s0b0s/first-person-gate-array/pcb/carrier.kicad_pcb

## KiCad design pcb/carrier.kicad_pcb (2026-10-25)

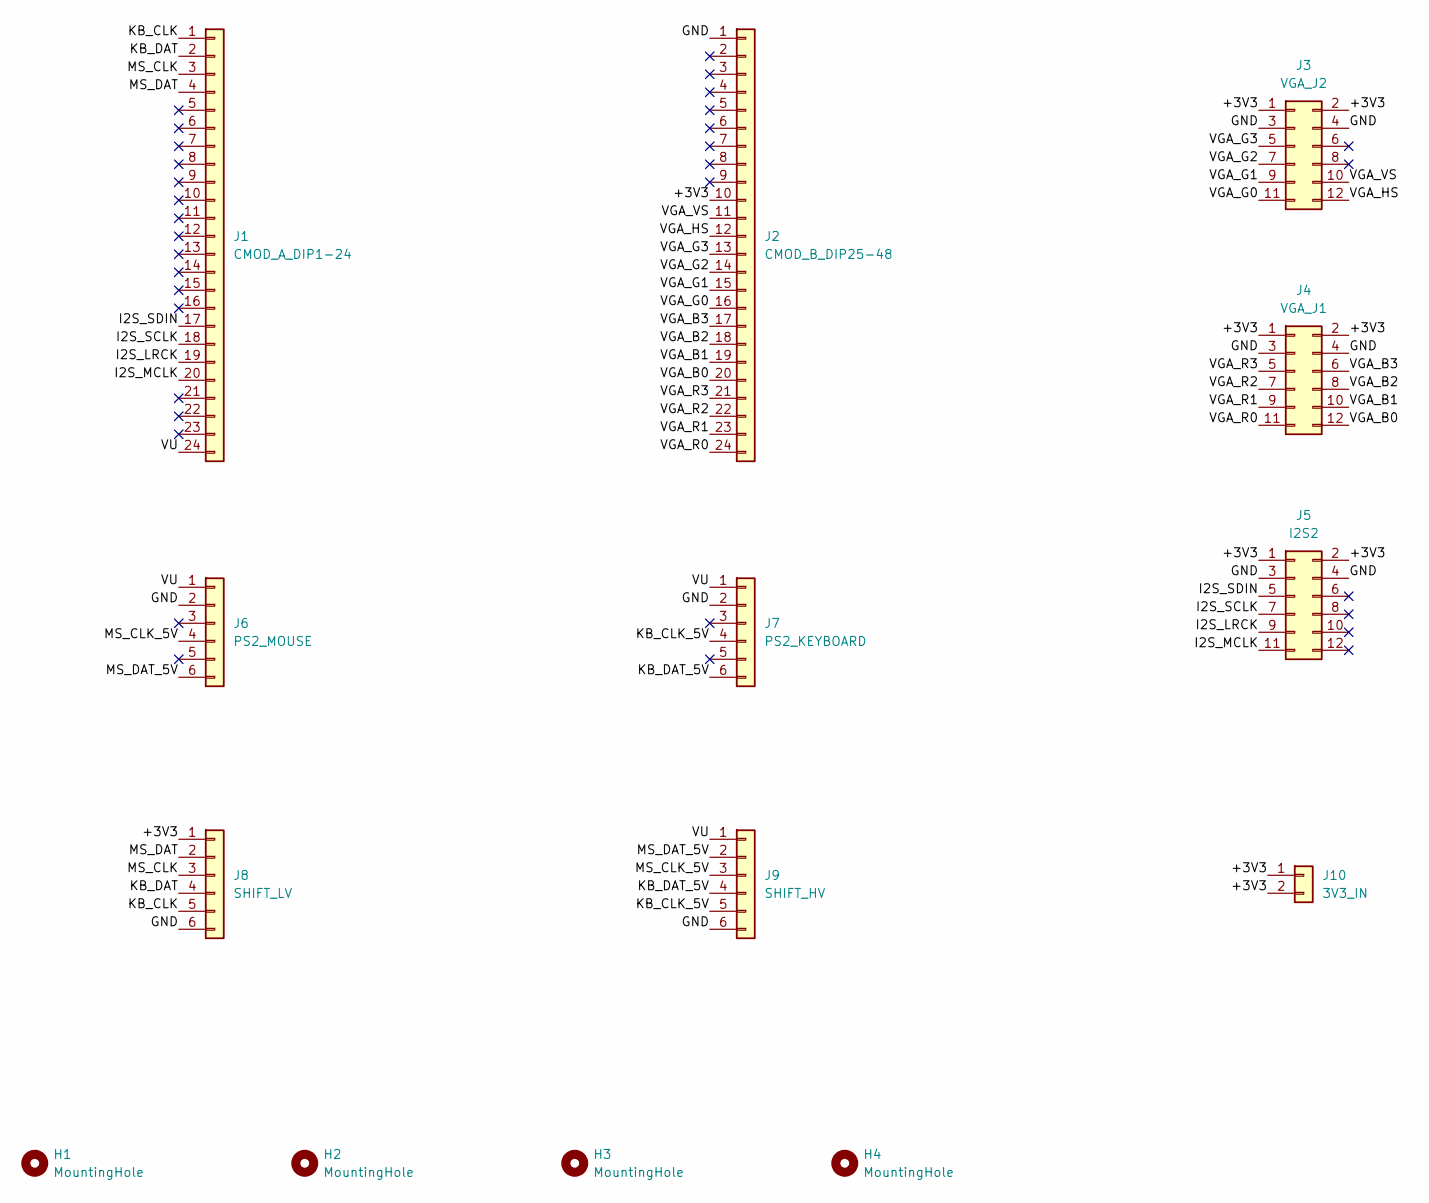
[picture p1: schematic carrier.kicad_sch, FPGA Shooter Game Carrier]

Parts:
H1, H2, H3, H4: MountingHole; MountingHole_3.2mm_M3
J1: CMOD_A_DIP1-24; PinSocket_1x24_P2.54mm_Vertical
J2: CMOD_B_DIP25-48; PinSocket_1x24_P2.54mm_Vertical
J3: VGA_J2; PinSocket_2x06_P2.54mm_Horizontal_Edge2mm
J4: VGA_J1; PinSocket_2x06_P2.54mm_Horizontal_Edge2mm
J5: I2S2; PinSocket_2x06_P2.54mm_Horizontal_Edge2mm
J6: PS2_MOUSE; PinSocket_1x06_P2.54mm_Horizontal_Edge2mm
J7: PS2_KEYBOARD; PinSocket_1x06_P2.54mm_Horizontal_Edge2mm
J8: SHIFT_LV; PinSocket_1x06_P2.54mm_Vertical
J9: SHIFT_HV; PinSocket_1x06_P2.54mm_Vertical
J10: 3V3_IN; PinSocket_1x02_P2.54mm_Vertical

Connections:
/+3V3: J2.10, J3.1, J3.2, J4.1, J4.2, J5.1, J5.2, J8.1, J10.1, J10.2
/GND: J2.1, J3.3, J3.4, J4.3, J4.4, J5.3, J5.4, J6.2, J7.2, J8.6, J9.6
/I2S_LRCK: J1.19, J5.9
/I2S_MCLK: J1.20, J5.11
/I2S_SCLK: J1.18, J5.7
/I2S_SDIN: J1.17, J5.5
/KB_CLK: J1.1, J8.5
/KB_CLK_5V: J7.4, J9.5
/KB_DAT: J1.2, J8.4
/KB_DAT_5V: J7.6, J9.4
/MS_CLK: J1.3, J8.3
/MS_CLK_5V: J6.4, J9.3
/MS_DAT: J1.4, J8.2
/MS_DAT_5V: J6.6, J9.2
/VGA_B0: J2.20, J4.12
/VGA_B1: J2.19, J4.10
/VGA_B2: J2.18, J4.8
/VGA_B3: J2.17, J4.6
/VGA_G0: J2.16, J3.11
/VGA_G1: J2.15, J3.9
/VGA_G2: J2.14, J3.7
/VGA_G3: J2.13, J3.5
/VGA_HS: J2.12, J3.12
/VGA_R0: J2.24, J4.11
/VGA_R1: J2.23, J4.9
/VGA_R2: J2.22, J4.7
/VGA_R3: J2.21, J4.5
/VGA_VS: J2.11, J3.10
/VU: J1.24, J6.1, J7.1, J9.1

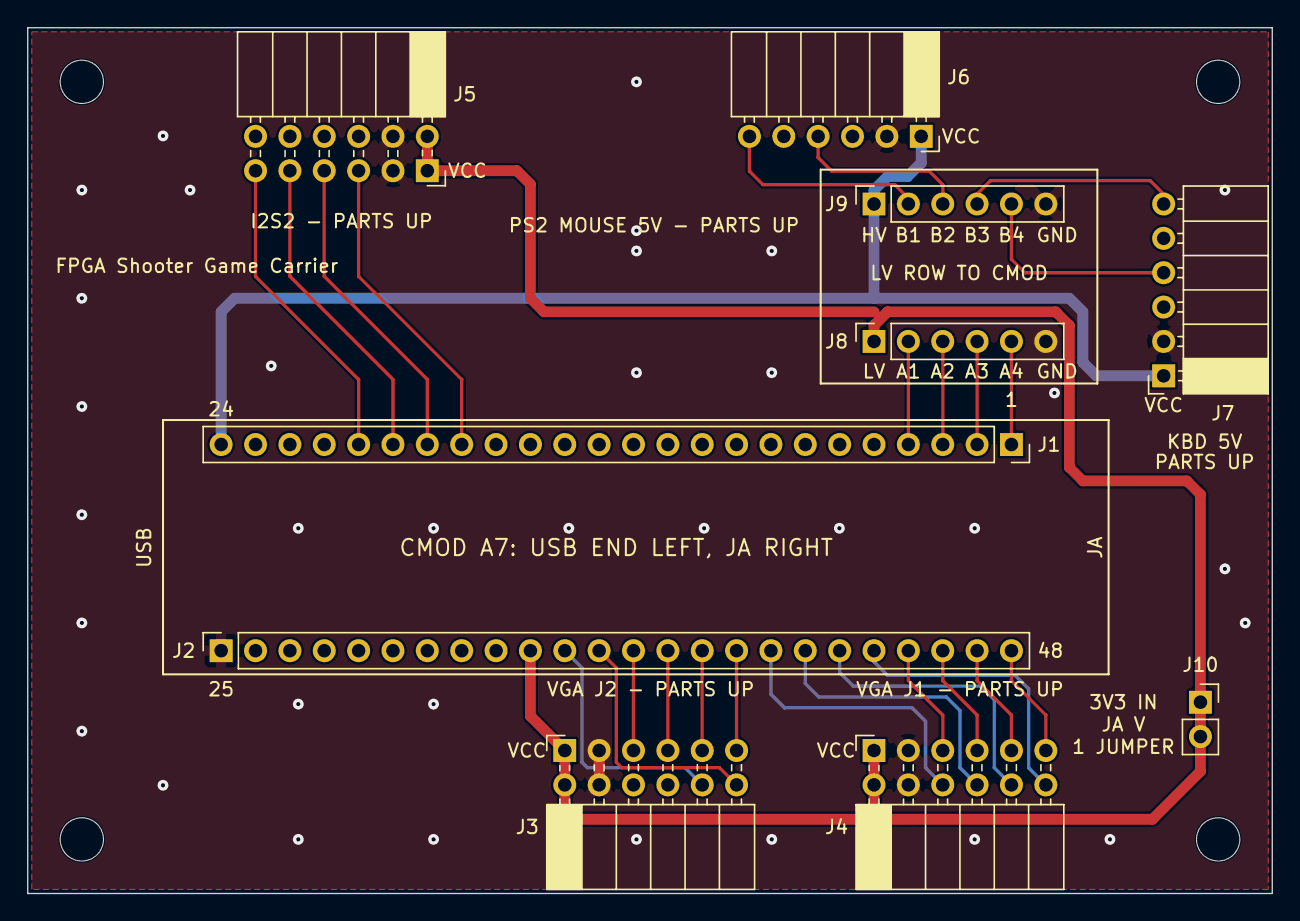
[picture p2: board carrier.kicad_pcb from above]

Board: 2 copper layers, 92.0 x 64.0 mm, 14 parts (0 on the bottom side), 29 nets.
