s0b0s/first-person-gate-array/rtl/render/sprite_engine.vhd

--------------------------------------------------------------------------
-- Company:        Johns Hopkins University Whiting School of Engineering
--                 Department of Electrical and Computer Engineering
-- Engineer:       Matthew Gordon
--
-- Create Date:    10/21/2026
-- Design Name:    Sprite Engine
-- Module Name:    sprite_engine
-- Project Name:   First-Person Gate Array
-- Target Devices: Digilent Cmod A7-35T, Artix-7 FPGAs
-- Tool versions:  Vivado 2025.1, VHDL-93
-- Description:    Draws the frame's sprites (enemies, items, fireballs) over
--                 the walls, matching tools/model/sprites.py bit for bit.
--                 Pass 1: for every sprite table entry, depth =
--                   (rx * cos + ry * sin) >> 16 with rx, ry = (x << 6) - cam
--                   (Q.16 tiles); entries with depth < 1/8 tile are culled.
--                 Pass 2: repeatedly pick the farthest remaining entry
--                   (strictly larger depth wins, so equal depths keep table
--                   order: the model's stable sort), project it in full:
--                     lateral = (-rx * sin + ry * cos) >> 16
--                     lh      = min(N_LH / depth, LH_MAX)       (divider)
--                     w_f, h_f = (lh * width) >> 6, (lh * height) >> 6
--                     left    = 40960 + ((lateral * lh) >> 16) - (w_f >> 1)
--                     bottom  = 30720 + ((lh * (eye - floor)) >> 6),
--                               top = bottom - h_f (floor: the sprite's floor
--                               height, stage 4; eye - floor may be negative)
--                     x0, x1, y0, y1 by the pixel-center rule, clipped
--                     step    = (depth * M_TS) >> 16  texels per pixel, Q.16
--                   then draw it at once, column by column: a column is
--                   drawn only where z = min(depth >> 6, 65535) is below the
--                   wall z; u starts at ((x0 * 256 + 128 - left) * step) >> 8
--                   and v at ((y0 * 256 + 128 - top) * step) >> 8 and both
--                   advance by step (exact: ((d + 256) * s) >> 8 equals
--                   ((d * s) >> 8) + s), clamped to the frame size.
--                   Stage 4 clip windows: before a column is drawn its clip
--                   list (render_top: count and entries, nearest first) is
--                   scanned, one entry per clock, for the last entry with
--                   entry z <= sprite z; only rows inside that window are
--                   read and written (rows 0..239 without entries). Rows
--                   above the window are skipped one per clock while v
--                   still advances, rows below it end the column.
--                 Texels are read from the art in SRAM (column-major at
--                 ART_BASE + frame offset + u * height + v) through an
--                 arbiter master port, several reads in flight. Each read
--                 carries its pixel address and light level through a
--                 16-word FIFO; returned texels other than 255 go through
--                 the light table into a 16-word output FIFO feeding the
--                 pixel port. A read is issued only while
--                 reads in flight + pipeline + output FIFO < 12, so neither
--                 FIFO can overflow under back-pressure.
--                 Spans (actor index, x0, x1, z) of every target sprite that
--                 survives culling are written in drawing order into the
--                 bank not being read; the banks swap when the frame ends,
--                 so the game always reads the last finished frame.
--                 Multiplies share one signed 32 x 25 multiplier with three
--                 pipeline registers (4 clocks per product); one divider.
--                 Clock domain: clk_i (system). About 100 clocks per sprite
--                 plus about 4 clocks per drawn texel (2 per SRAM read and
--                 2 per pixel write share the SRAM).
--
-- Dependencies:   VHDL-93, IEEE.std_logic_1164, IEEE.numeric_std, render_pkg,
--                 render_types_pkg, game_pkg, game_tables_pkg, hw_pkg,
--                 divider, light_rom, sprite_fifo
--
-- Revision:
-- Revision 0.01 - File Created
-- Revision 1.00 - First working version
-- Revision 2.00 - Stage 4: sprite floor height, clip windows
-- Additional Comments:
--                 None.
--------------------------------------------------------------------------
library IEEE;
use IEEE.std_logic_1164.all;
use IEEE.numeric_std.all;
use work.hw_pkg.all;
use work.game_pkg.all;
use work.render_pkg.all;
use work.render_types_pkg.all;
use work.game_tables_pkg.all;

entity sprite_engine is
	port(
		clk_i: in std_logic; -- System clock
		rst_i: in std_logic; -- Asynchronous reset, active high
		start_i: in std_logic; -- Pulse after the walls are done
		cam_x_i: in std_logic_vector(POS_BITS - 1 downto 0); -- Camera x, Q6.16
		cam_y_i: in std_logic_vector(POS_BITS - 1 downto 0); -- Camera y, Q6.16
		angle_i: in std_logic_vector(ANGLE_BITS - 1 downto 0); -- View angle
		eye_i: in std_logic_vector(EYE_BITS - 1 downto 0); -- Eye height 0..127
		buf_i: in std_logic; -- Framebuffer to draw
		spr_addr_o: out std_logic_vector(4 downto 0); -- Sprite table read, 1 clock
		spr_data_i: in std_logic_vector(SPR_BITS - 1 downto 0);
		spr_count_i: in std_logic_vector(5 downto 0); -- Entries in the table
		zwall_addr_o: out std_logic_vector(8 downto 0); -- Wall z read, 1 clock
		zwall_data_i: in std_logic_vector(15 downto 0);
		clip_addr_o: out std_logic_vector(12 downto 0); -- Clip entry read: column & index, 1 clock
		clip_data_i: in std_logic_vector(CLIP_BITS - 1 downto 0);
		ccount_addr_o: out std_logic_vector(8 downto 0); -- Clip entry count of a column, 1 clock
		ccount_data_i: in std_logic_vector(4 downto 0);
		m_req_o: out std_logic; -- SRAM arbiter master port (reads)
		m_addr_o: out std_logic_vector(18 downto 0);
		m_gnt_i: in std_logic;
		m_rvalid_i: in std_logic;
		m_rdata_i: in std_logic_vector(7 downto 0);
		pix_valid_o: out std_logic; -- Pixel write port
		pix_ready_i: in std_logic;
		pix_data_o: out std_logic_vector(PIXW_BITS - 1 downto 0);
		span_raddr_i: in std_logic_vector(4 downto 0); -- Spans of the last frame
		span_rdata_o: out std_logic_vector(SPAN_BITS - 1 downto 0);
		span_count_o: out std_logic_vector(5 downto 0);
		busy_o: out std_logic; -- Frame in progress
		done_o: out std_logic; -- Pulse: every sprite pixel accepted
		pixels_o: out std_logic_vector(15 downto 0) -- Sprite pixels last frame (saturates)
	);
end sprite_engine;
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
