s0b0s/first-person-gate-array/rtl/bringup/text_painter.vhd

--------------------------------------------------------------------------
-- Company:        Johns Hopkins University Whiting School of Engineering
--                 Department of Electrical and Computer Engineering
-- Engineer:       Matthew Gordon
--
-- Create Date:    10/21/2026
-- Design Name:    Text Painter
-- Module Name:    text_painter
-- Project Name:   First-Person Gate Array
-- Target Devices: Digilent Cmod A7-35T, Artix-7 FPGAs
-- Tool versions:  Vivado 2025.1, VHDL-93
-- Description:    Draws the 40 x 30 character bring-up page (page_rom) into
--                 a 320x240 framebuffer through the pixel write port, once
--                 per start_i pulse, so the page shows live values. This
--                 stands in for the renderer in the bring-up design and
--                 exercises the same path: pixel FIFO, SRAM writes, buffer
--                 manager swap, display.
--                 Order: for each pixel row y (0..239), for each cell
--                 column (0..39): fetch the page cell (row y / 8), turn a
--                 field cell into a hex digit of its value word, fetch the
--                 font row (y mod 8), emit 8 pixels left to right.
--                 States per cell:
--                   S_CELL  page ROM address on the bus (from counters)
--                   S_CHAR  page cell valid; character -> font address
--                   S_LOAD  font row valid; copy it and the color
--                   S_EMIT  8 pixels, each waiting for pix_ready_i
--                 Colors (palette_pkg): row 0 yellow, value digits light
--                 green, other text white, background black.
--                 done_o pulses when the last pixel has been taken by the
--                 FIFO (the FIFO may still be writing it to SRAM).
--                 Clock domain: clk_i (system). About 11 cycles per 8
--                 pixels when the FIFO does not stall; the SRAM takes 16.
--
-- Dependencies:   VHDL-93, IEEE.std_logic_1164, IEEE.numeric_std, game_pkg,
--                 palette_pkg, page_rom, font_rom
--
-- Revision:
-- Revision 0.01 - File Created
-- Revision 1.00 - First working version
-- Additional Comments:
--                 None.
--------------------------------------------------------------------------
library IEEE;
use IEEE.std_logic_1164.all;
use IEEE.numeric_std.all;
use work.game_pkg.all;
use work.palette_pkg.all;

entity text_painter is
	port(
		clk_i: in std_logic; -- System clock
		rst_i: in std_logic; -- Asynchronous reset, active high
		start_i: in std_logic; -- Pulse: draw one page
		buf_i: in std_logic; -- Framebuffer to draw (latched at start_i)
		values_i: in std_logic_vector(32 * 32 - 1 downto 0); -- Value word w = bits 32w+31..32w
		pix_valid_o: out std_logic; -- Pixel write port
		pix_ready_i: in std_logic;
		pix_data_o: out std_logic_vector(PIXW_BITS - 1 downto 0); -- buf, addr, index
		busy_o: out std_logic; -- Drawing
		done_o: out std_logic -- Pulse: last pixel taken
	);
end text_painter;
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
