s0b0s/first-person-gate-array/(commit log)

2026-10-22 Initial version of First-Person Gate Array completed with all stages, testbenches, and tools
2026-10-25 Added carrier PCB design files and updated constraints
    [carrier.kicad_pcb, carrier.kicad_sch]
2026-10-25 Updated PCB files after ordering
    [carrier.kicad_pcb]
